ReikoR/instaspin-bldc-driver/NC Drill/instaspin_bldc_driver.TXT

M48
;Layer_Color=9474304
;FILE_FORMAT=2:4
INCH,TZ
;TYPE=PLATED
T1F00S00C0.0157
T2F00S00C0.0197
T3F00S00C0.0315
;TYPE=NON_PLATED
T4F00S00C0.0591
%
T01
X13366Y470
X6811Y4685
X6890Y5522
X7441Y5484
X7362Y6378
X6142Y5827
X4882Y5925
X3937Y5906
X3465Y5906
X2992
X2520
X1575Y5354
X709Y5630
X866Y6535
X1870Y7756
Y8228
X1929Y8661
X2323Y9803
X2930Y9830
X3504Y10118
X3504Y9528
X4055Y9488
X3976Y9094
X5157Y9213
X5130Y9588
X5157Y9961
X5157Y10433
X5157Y10976
X5157Y11378
X7120Y11339
X7078Y11693
X7120Y10748
Y10354
Y9764
Y9370
X7008Y9016
X6940Y8661
X6940Y8307
X7008Y7953
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
