ReikoR/instaspin-bldc-driver/instaspin_bldc_driver.PDF

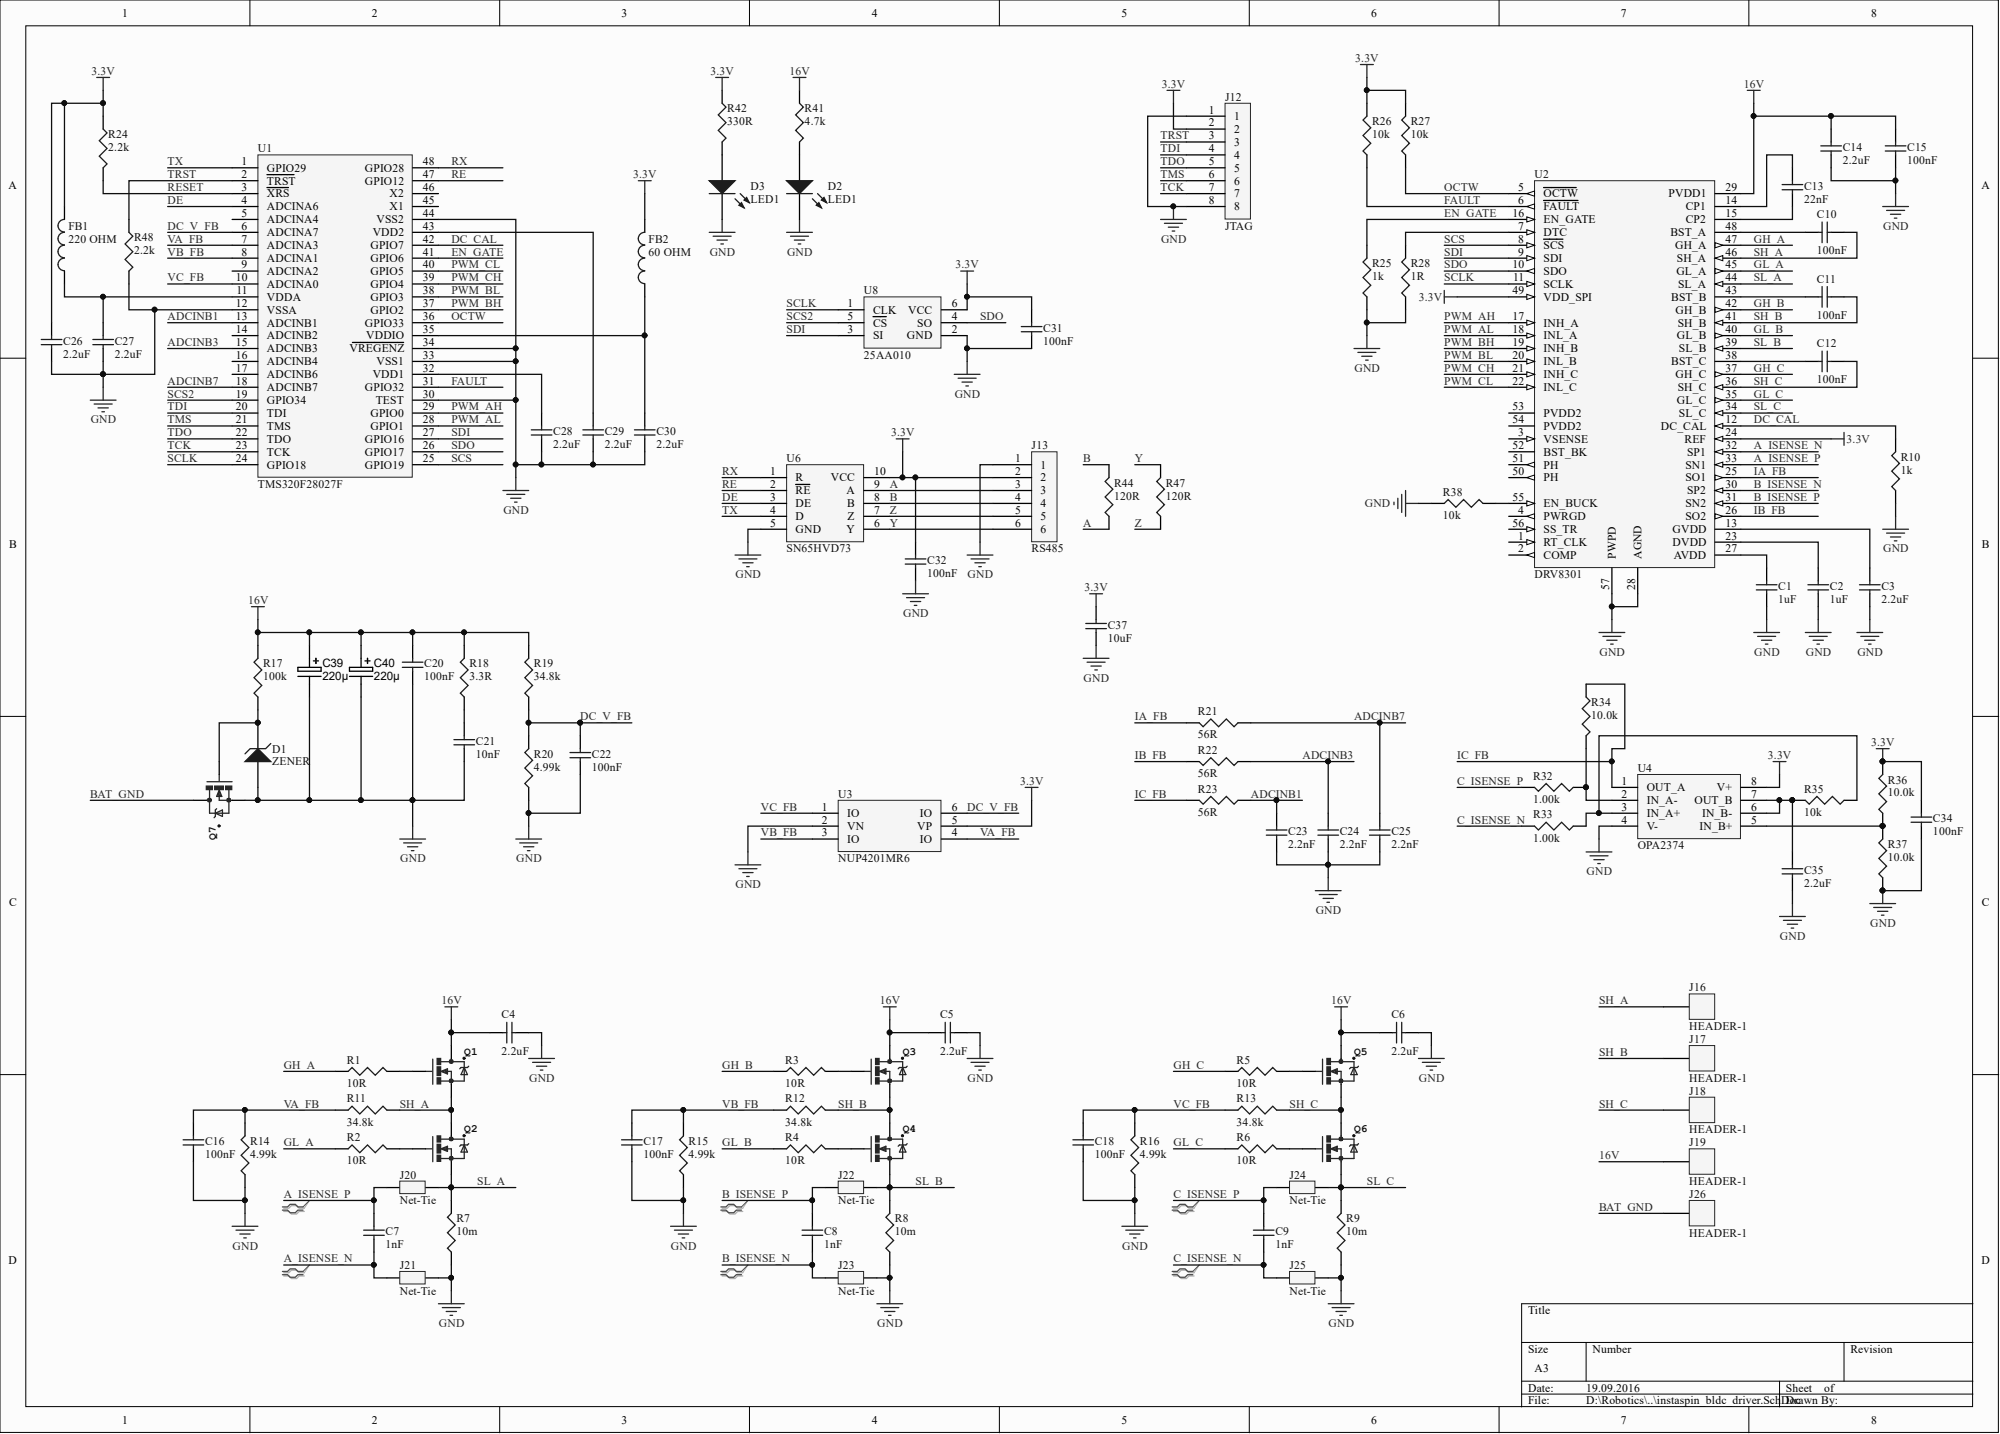
[picture p1: page 1]
