ReikoR/instaspin-bldc-driver/(list of files, drawings)

Other design files:
instaspin_bldc_driver.PcbDoc
instaspin_bldc_driver.PrjPcb
instaspin_bldc_driver.SchDoc
