ReikoR/instaspin-bldc-driver/(commit log)

2015-02-26 Created initial schematic and board
    [instaspin_bldc_driver.PcbDoc, instaspin_bldc_driver.PrjPcb, instaspin_bldc_driver.SchDoc]
2015-03-09 Finished most of the schematic
    [instaspin_bldc_driver.PcbDoc, instaspin_bldc_driver.PrjPcb, instaspin_bldc_driver.SchDoc]
2015-03-12 Moved components for better overview
    [instaspin_bldc_driver.PcbDoc, instaspin_bldc_driver.SchDoc]
2015-03-17 Removed buck regulator components. Replaced half duplex RS485 driver with full duplex driver. Started with PCB layout.
    [instaspin_bldc_driver.PcbDoc, instaspin_bldc_driver.SchDoc]
2015-03-19 Improved PCB layout
    [instaspin_bldc_driver.PcbDoc]
2015-03-24 More compact component placement. Started routing
    [instaspin_bldc_driver.PcbDoc, instaspin_bldc_driver.PrjPcb, instaspin_bldc_driver.SchDoc]
2015-03-31 Most of the PCB done
    [instaspin_bldc_driver.PcbDoc, instaspin_bldc_driver.PrjPcb, instaspin_bldc_driver.SchDoc]
2015-04-07 Some layout changes. Created gerber and BOM outputs.
    [instaspin_bldc_driver.PcbDoc, instaspin_bldc_driver.PrjPcb, instaspin_bldc_driver.SchDoc]
2015-04-14 Some small layout changes. Switched TDO and TMS signals.
    [instaspin_bldc_driver.PcbDoc, instaspin_bldc_driver.PrjPcb, instaspin_bldc_driver.SchDoc]
2015-05-26 Fixed incorrect L1 connection. Added pulldown to TRST. Corrected LED resistor values. Added polygon to reverse voltage protection MOSFET GND legs.
    [instaspin_bldc_driver.PcbDoc, instaspin_bldc_driver.PrjPcb, instaspin_bldc_driver.SchDoc]
2015-06-16 Changed designators and added values to ferrite beads. Added PDF schematic output.
    [instaspin_bldc_driver.PcbDoc, instaspin_bldc_driver.SchDoc]
2015-07-18 Changed RS485 connector position. Moved power terminals. Connected DE to MCU pin. Added SPI EEPROM.
    [instaspin_bldc_driver.PcbDoc, instaspin_bldc_driver.PrjPcb, instaspin_bldc_driver.SchDoc]
2015-07-29 Added PCI Express compatible card edge
    [instaspin_bldc_driver.PcbDoc, instaspin_bldc_driver.SchDoc]
2015-08-22 Via placement changes
    [instaspin_bldc_driver.CSV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]
2015-10-06 Updated footprints to show step models.
    [instaspin_bldc_driver.PcbDoc, instaspin_bldc_driver.PrjPcb, instaspin_bldc_driver.SchDoc]
2016-08-22 3.3V RS485, banana power connectors, SPI EEPROM
    [instaspin_bldc_driver.CSV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]
2016-09-19 Removed generated files from project tree
    [instaspin_bldc_driver.PrjPcb]
